kit-kch/cd101-tt/docs/UPduino_v3.0.pdf

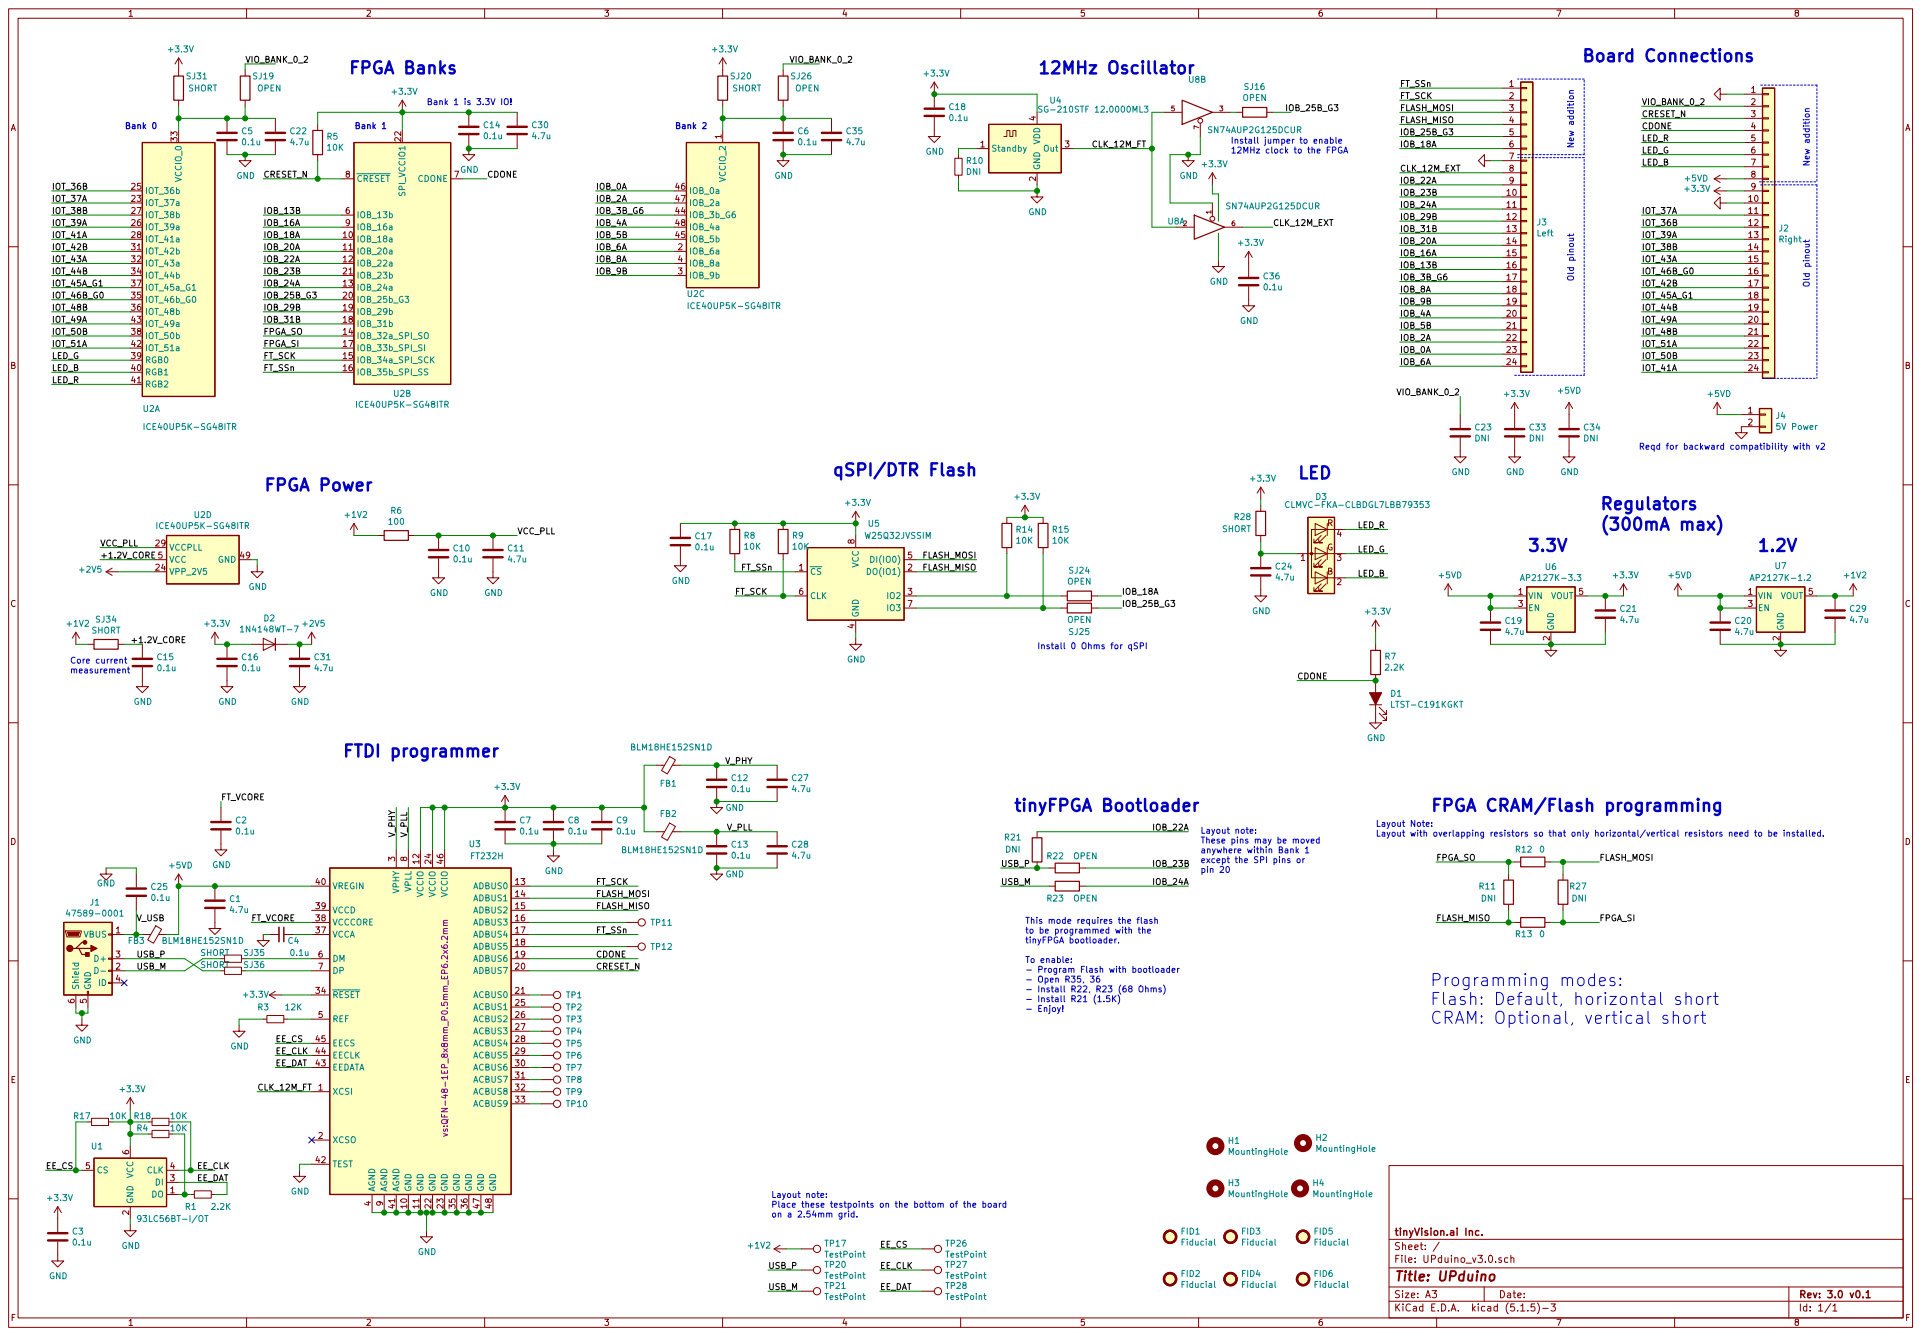
[picture p5: page 1]

Bank 1 is 3.3V IO! FTDI programmer

Install jumper to enable 12MHz clock to the FPGA

Install 0 Ohms for qSPI

Layout note:
These pins may be moved
anywhere within Bank 1
except the SPI pins or

Layout Note:
Layout with overlapping resistors so that only horizontal/vertical resistors need to be installed.

4 VREGIN 40 AGND 41 TEST 42 EEDATA 43 EECLK 44 EECS 45 VCCIO 46 GND 47 GND 48 REF 5 DM 6 DP 7 VPLL

3 ACBUS6 30 ACBUS7 31 ACBUS8 32 ACBUS9 33 RESET 34 GND 35 GND 36 VCCA 37 VCCCORE 38 VCCD 39 AGND

This mode requires the flash
to be programmed with the
tinyFPGA bootloader. To enable: - Program Flash with bootloader

Programming modes:
Flash: Default, horizontal short
CRAM: Optional, vertical short

2 DI 3 CLK 4 CS 5 VCC

Place these testpoints on the bottom of the board
on a 2.54mm grid.

File: UPduino_v3.0.sch Sheet: / tinyVision.ai Inc.
