kit-kch/cd101-tt/TODO.md

* Properly calculate knobs for synth
* Fix frequency calculation for filter and make knob control frequency, not raw coeff
* Constrain clocks for ASIC
