kit-kch/cd101-tt/src/hdl/dac.v

/*
 * Based on: https://www.fpga4fun.com/PWM_DAC_2.html
 *           https://www.fpga4fun.com/PWM_DAC_3.html 
 * See also: https://dsp.stackexchange.com/questions/69004/how-does-the-worlds-simplest-sigma-delta-dac-work
 *           https://www.edaboard.com/threads/resolution-of-a-sigma-delta-modulator.280812/
 *           https://www.beis.de/Elektronik/DeltaSigma/DeltaSigma_D.html
 * 1024x Oversampling is then ~14 ENOB
 */

module dac (
    input clk,
    input rstn,
    input[15:0] din,
    output dout
);

    reg[16:0] accumulator;
    always @(posedge clk) begin
        if (rstn == 1'b0)
            accumulator <= 0;
        else
            accumulator <= accumulator[15:0] + din;
    end
    assign dout = accumulator[16];

endmodule
