kit-kch/cd101-tt/src/hdl/fpga_pll.v

/**
 * PLL configuration
 *
 * This Verilog module was generated automatically
 * using the icepll tool from the IceStorm project.
 * Use at your own risk.
 *
 * Given input frequency:        48.000 MHz
 * Requested output frequency:   20.480 MHz
 * Achieved output frequency:    20.500 MHz
 */

module fpga_pll(
        input  clock_in,
        output clock_out,
        output locked
        );

SB_PLL40_CORE #(
                .FEEDBACK_PATH("SIMPLE"),
                .DIVR(4'b0010),         // DIVR =  2
                .DIVF(7'b0101000),      // DIVF = 40
                .DIVQ(3'b101),          // DIVQ =  5
                .FILTER_RANGE(3'b001)   // FILTER_RANGE = 1
        ) uut (
                .LOCK(locked),
                .RESETB(1'b1),
                .BYPASS(1'b0),
                .REFERENCECLK(clock_in),
                .PLLOUTCORE(clock_out)
                );

endmodule
