kit-kch/cd101-tt/(commit log)

2025-01-15 Add filter implementation
2025-01-16 Ultra simple SPI module
2025-01-16 Devcontainer: PAss through devices for FPGA programming
2025-01-21 WIP: Add SPI
2025-01-23 Oscillator: 12 bit only
    [oscillator.v, spi.v, synth.v, synth_top.v]
2025-01-23 Oscillator: Add syn rstn
    [oscillator.v, oscillator_tb.v, synth.v]
2025-01-23 Fix filter
2025-01-23 Add arstn to SPI module
2025-01-23 Synchronize trig and rstn signals
    to the adsr clock, so the whole system resets with adsr clock. Exception: The rstn for the clock generator is synched to the main clk and samples the reset edge
    [spi.v, synth.v, synth_top.v]
2025-01-23 Add SPI trigger setting support
    First bit written is always trigger.
    When only writing one bit, there will be no reset
    [spi.v, spi_tb.v]
2025-01-24 USe async reset in clkgen
    [clkdiv.v, clkdiv_tb.v, synth.v, tff.v]
2025-01-28 SPI: Make LSB first
2025-01-28 Constrain SPI CLK for 1 MHz
2025-01-28 Fix multiplier reset for hardware
    [clkdiv.v, filter.v, shift_mult16.v, shift_mult8.v, synth.v]
2025-02-04 Use 4 times faster ADSR clock
    So minimum time slot should be 3.125ms instead of 12.5ms
2025-02-06 Insert more buffer cells
2025-02-11 Fix easy lint warnings
    [adsr.v, clkdiv.v, shift_mult16.v, shift_mult8.v]
2025-02-11 Fix one more unused signal
    [shift_mult16.v]
2025-02-11 shift_mult: only sync reset
    This needs testing if it still works
    [shift_mult16.v, shift_mult8.v]
2025-02-11 Try to fix DRC error
    [shift_mult16.v, shift_mult8.v]
2025-02-11 Revert "Try to fix DRC error"
    This reverts commit 673b4e401df329d1550b9ae7e7a32cdbe20e9bd1.
    [shift_mult16.v, shift_mult8.v]
2025-02-11 Revert "shift_mult: only sync reset"
    This reverts commit bddd2aaa6bdb7025d697bf286f26acecb12be256.
    [shift_mult16.v, shift_mult8.v]
2025-02-11 Fix ADSR FSM sensitivity list
    [adsr.v]
2025-02-11 Fix last linter warning
    [adsr.v]
2025-02-13 Add USE_CFG_LATCH variation
    Untested. Latches the configuration, so that the system does not have to
    go to reset during configuration.
    Untested, needs testing on FPGA. This also doesn't fit TinyTapeout 1
    tile but it can be used with more tiles or with IHP.
    [spi.v, synth.v, synth_top.v]
2025-02-18 iverilog thinks we need a reset here
    [filter.v, synth.v]
2025-02-18 Start cocotb testbench: Write SPI
2025-02-18 Revert "Add USE_CFG_LATCH variation"
    This reverts commit ad357c64d802937de8ec6fc0aeb7810470bd9a28.
    Use a mroe complex design for IHP later
    [spi.v, synth.v, synth_top.v]
2025-02-19 Try async reset for filter
    [filter.v, synth.v]
2025-02-19 Fix Multiplier
    Tested on Hardware. Other code was wrong and causing glitches
    [shift_mult16.v]
2025-02-19 Test: Filter audio, write to .wav file, compare to golden reference
2025-10-21 Add FPGA board to readme
